muhammmmadziam1234-eng/industrial-sensor-carrier-pcb/media/four-layer-inspection.png

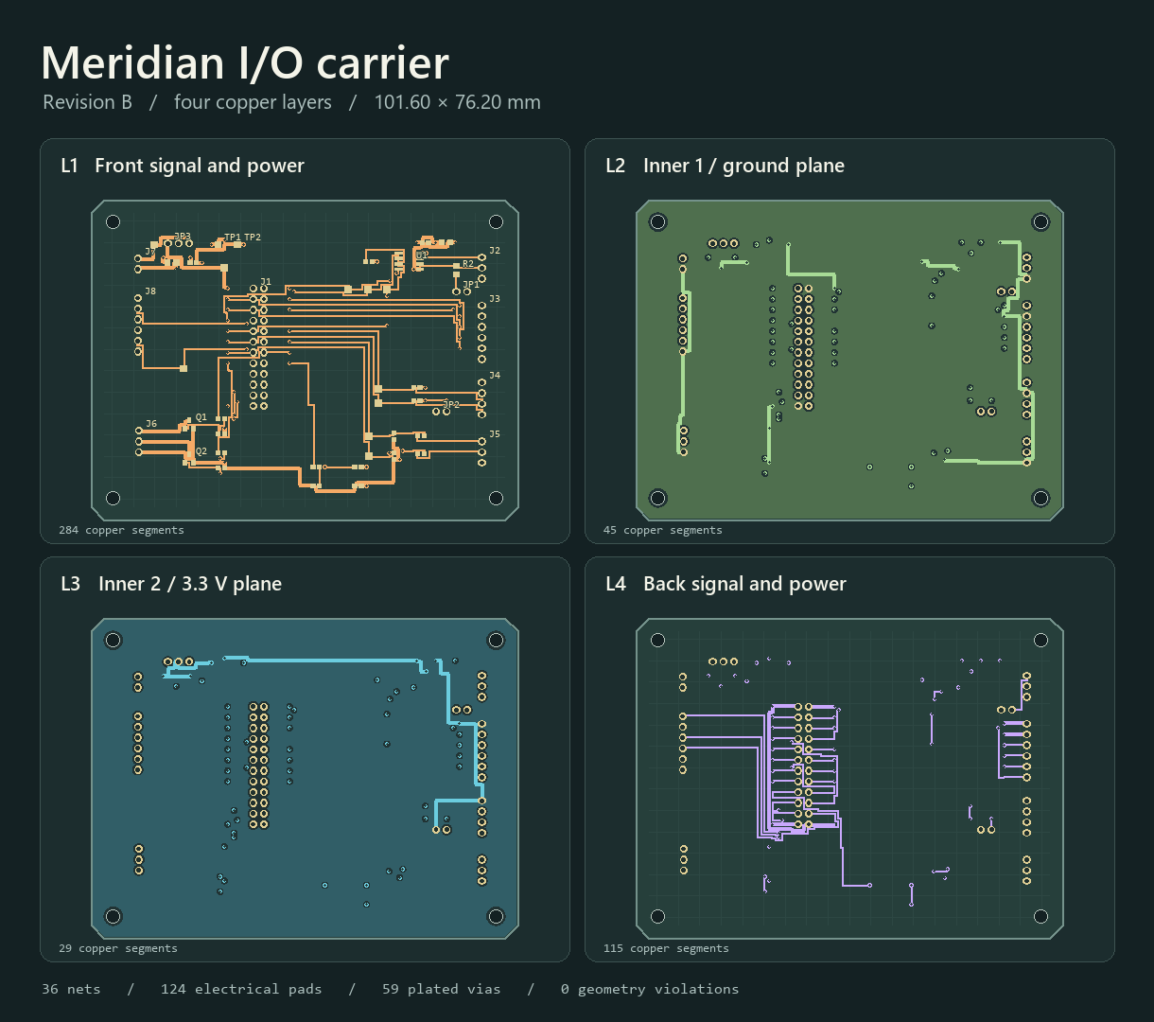
media/four-layer-inspection.png
