muhammmmadziam1234-eng/industrial-sensor-carrier-pcb/cad/pad-net-map.csv

Reference | Pad | Net | CAD x mm | CAD y mm | Drill mm
J1 | 1 | CTRL_3V3 | 38.608 | 55.118 | 1.05
J1 | 2 | GND | 41.148 | 55.118 | 1.05
J1 | 3 | SPI_SCK | 38.608 | 52.578 | 1.05
J1 | 4 | SPI_MOSI | 41.148 | 52.578 | 1.05
J1 | 5 | SPI_MISO | 38.608 | 50.038 | 1.05
J1 | 6 | SPI_CS0 | 41.148 | 50.038 | 1.05
J1 | 7 | UART_TX | 38.608 | 47.498 | 1.05
J1 | 8 | UART_RX | 41.148 | 47.498 | 1.05
J1 | 9 | RS_DIR | 38.608 | 44.958 | 1.05
J1 | 10 | I2C_SDA | 41.148 | 44.958 | 1.05
J1 | 11 | I2C_SCL | 38.608 | 42.418 | 1.05
J1 | 12 | ADC0 | 41.148 | 42.418 | 1.05
J1 | 13 | ADC1 | 38.608 | 39.878 | 1.05
J1 | 14 | OUT0 | 41.148 | 39.878 | 1.05
J1 | 15 | OUT1 | 38.608 | 37.338 | 1.05
J1 | 16 | LED0 | 41.148 | 37.338 | 1.05
J1 | 17 | LED1 | 38.608 | 34.798 | 1.05
J1 | 18 | RESET_N | 41.148 | 34.798 | 1.05
J1 | 19 | GPIO0 | 38.608 | 32.258 | 1.05
J1 | 20 | GPIO1 | 41.148 | 32.258 | 1.05
J1 | 21 | GPIO2 | 38.608 | 29.718 | 1.05
J1 | 22 | GPIO3 | 41.148 | 29.718 | 1.05
J1 | 23 | GND | 38.608 | 27.178 | 1.05
J1 | 24 | CTRL_3V3 | 41.148 | 27.178 | 1.05
J2 | 1 | RS_B | 92.964 | 62.484 | 1.05
J2 | 2 | RS_A | 92.964 | 59.944 | 1.05
J2 | 3 | GND | 92.964 | 57.404 | 1.05
J3 | 1 | 3V3 | 92.964 | 51.054 | 1.05
J3 | 2 | GND | 92.964 | 48.514 | 1.05
J3 | 3 | SPI_SCK | 92.964 | 45.974 | 1.05
J3 | 4 | SPI_MOSI | 92.964 | 43.434 | 1.05
J3 | 5 | SPI_MISO | 92.964 | 40.894 | 1.05
J3 | 6 | SPI_CS0 | 92.964 | 38.354 | 1.05
J4 | 1 | 3V3 | 92.964 | 32.766 | 1.05
J4 | 2 | GND | 92.964 | 30.226 | 1.05
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
TP6 | 1 | I2C_SDA | 68.326 | 31.242 | 0
TP7 | 1 | I2C_SCL | 68.326 | 27.940 | 0
TP8 | 1 | ADC0 | 66.040 | 20.066 | 0
TP9 | 1 | ADC1 | 66.040 | 15.240 | 0
TP10 | 1 | RESET_N | 22.098 | 36.068 | 0
TP11 | 1 | CTRL_3V3 | 31.750 | 59.944 | 0
TP12 | 1 | AUX_3V3 | 14.986 | 65.532 | 0
