muhammmmadziam1234-eng/industrial-sensor-carrier-pcb/cad/meridian-carrier-board.step

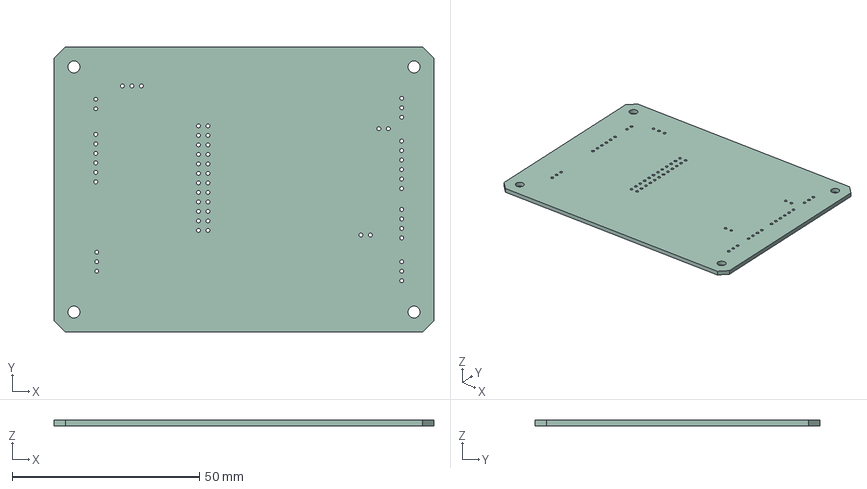
[picture p3: CAD file, 2026-11-12]
cad/meridian-carrier-board.step
101.6 x 76.2 x 1.51 mm
