muhammmmadziam1234-eng/industrial-sensor-carrier-pcb/cad/meridian-carrier.dxf

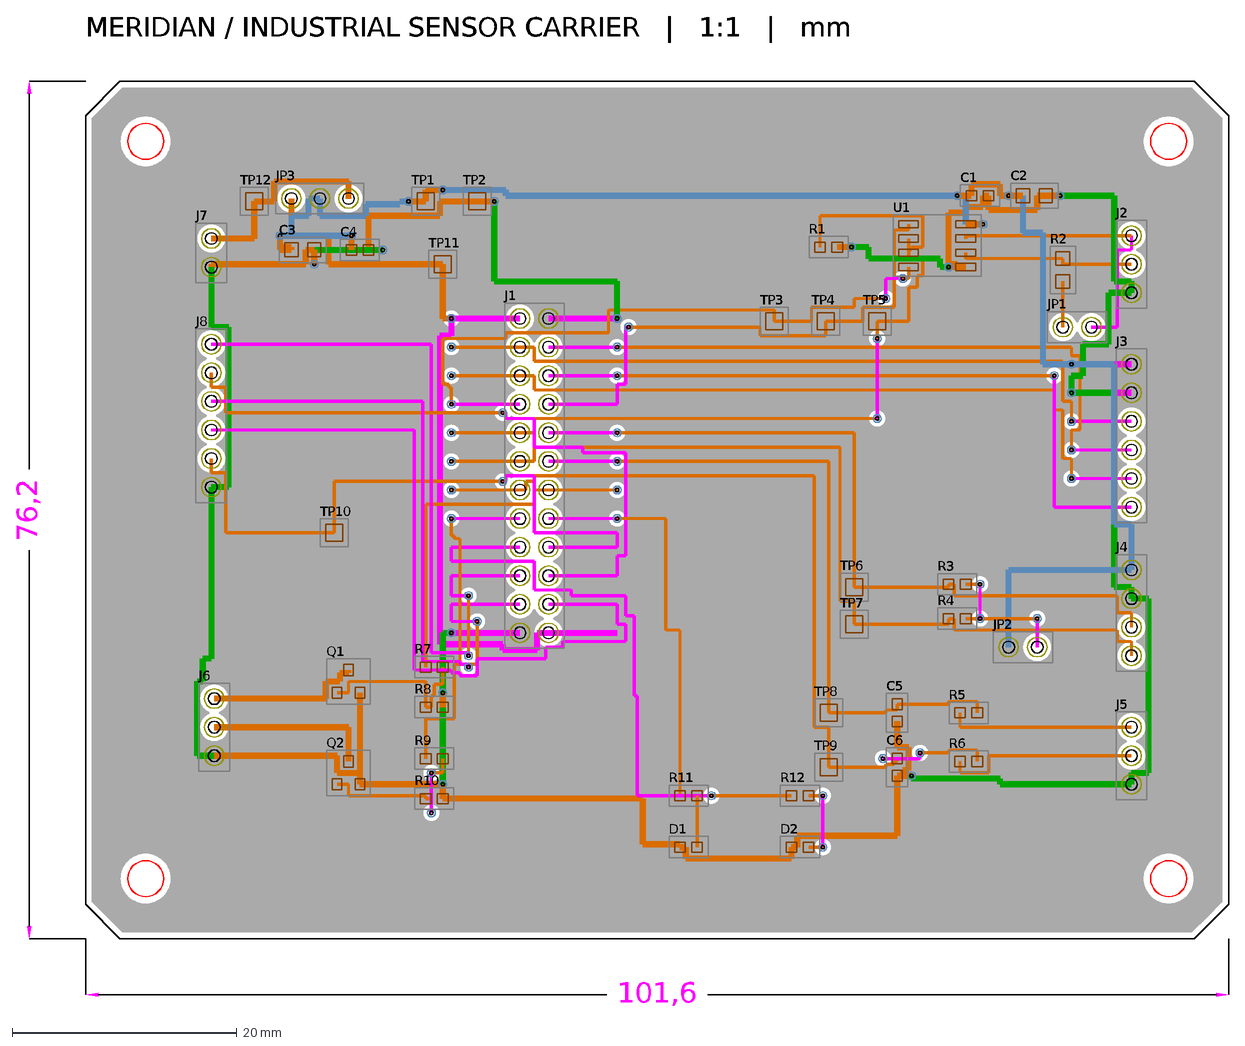
[picture p4: CAD file, 2026-11-12]
cad/meridian-carrier.dxf
J1
J2
J3
J4
J5
J6
J7
J8
JP1
JP2
JP3
U1
R1
R2
C1
C2
C3
C4
R3
R4
R5
R6
C5
C6
Q1
R7
R8
R11
D1
Q2
R9
R10
R12
D2
TP1
TP2
TP3
TP4
TP5
TP6
TP7
TP8
TP9
TP10
TP11
TP12
101,6
76,2
MERIDIAN / INDUSTRIAL SENSOR CARRIER | 1:1 | mm
