muhammmmadziam1234-eng/industrial-sensor-carrier-pcb/reports/meridian-schematic.pdf

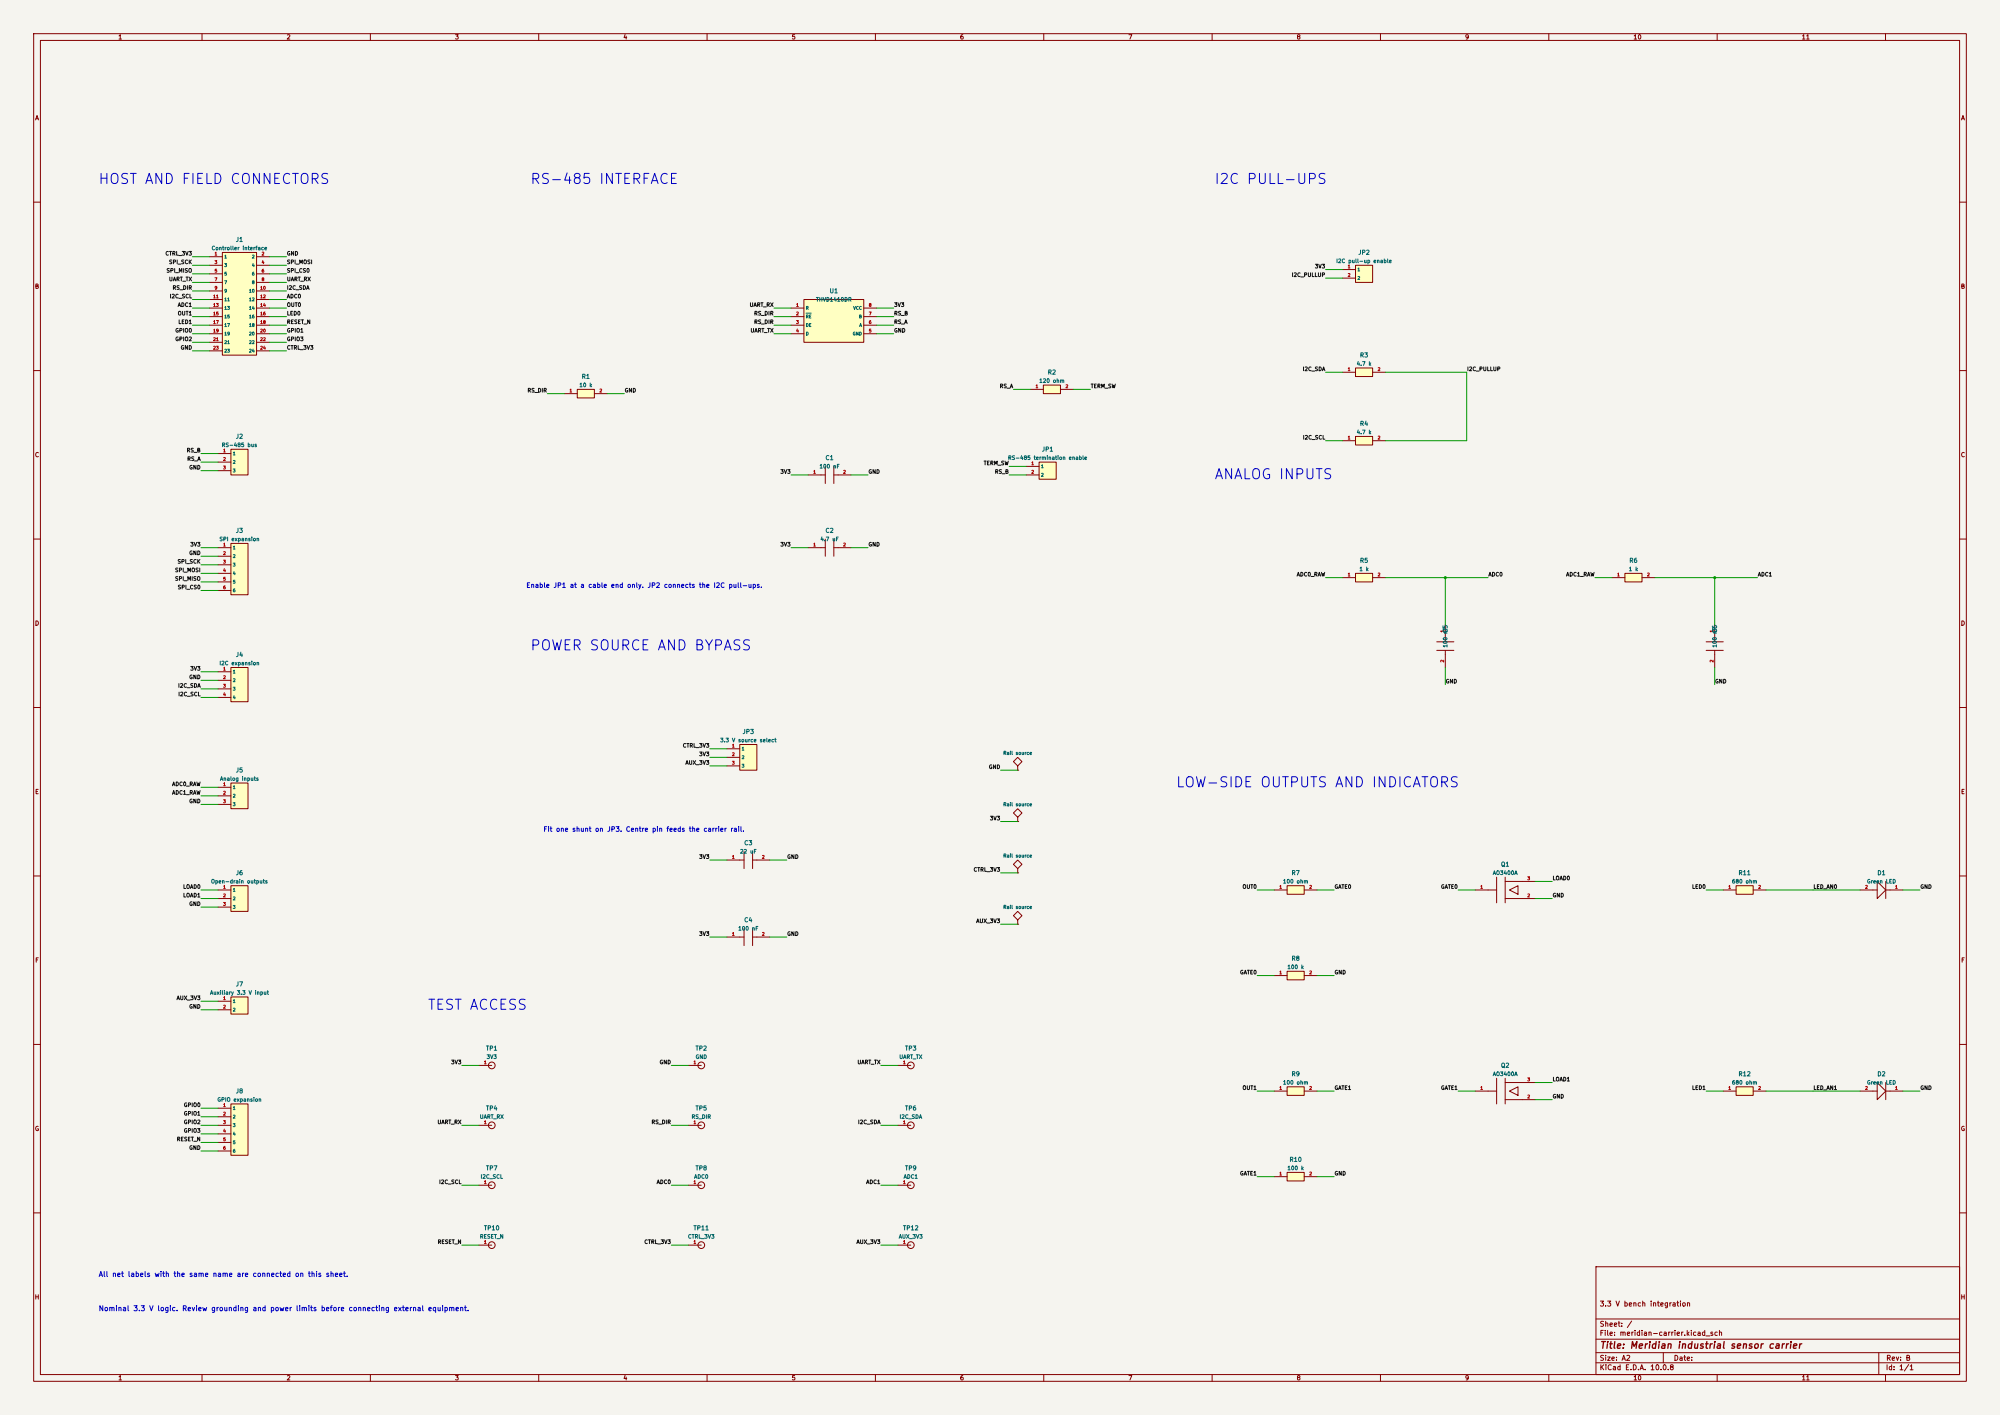
[picture p5: page 1]

POWER SOURCE AND BYPASS

Rail source

All net labels with the same name are connected on this sheet.

Nominal 3.3 V logic. Review grounding and power limits before connecting external equipment.

Sheet: /
File: meridian-carrier.kicad_sch
Title: Meridian industrial sensor carrier

Size: A2 | Rev: B
KiCad E.D.A. 10.0.8 | Id: 1/1
