muhammmmadziam1234-eng/industrial-sensor-carrier-pcb/cad/meridian-carrier.kicad_pcb

## KiCad design cad/meridian-carrier.kicad_pcb (2026-11-12)

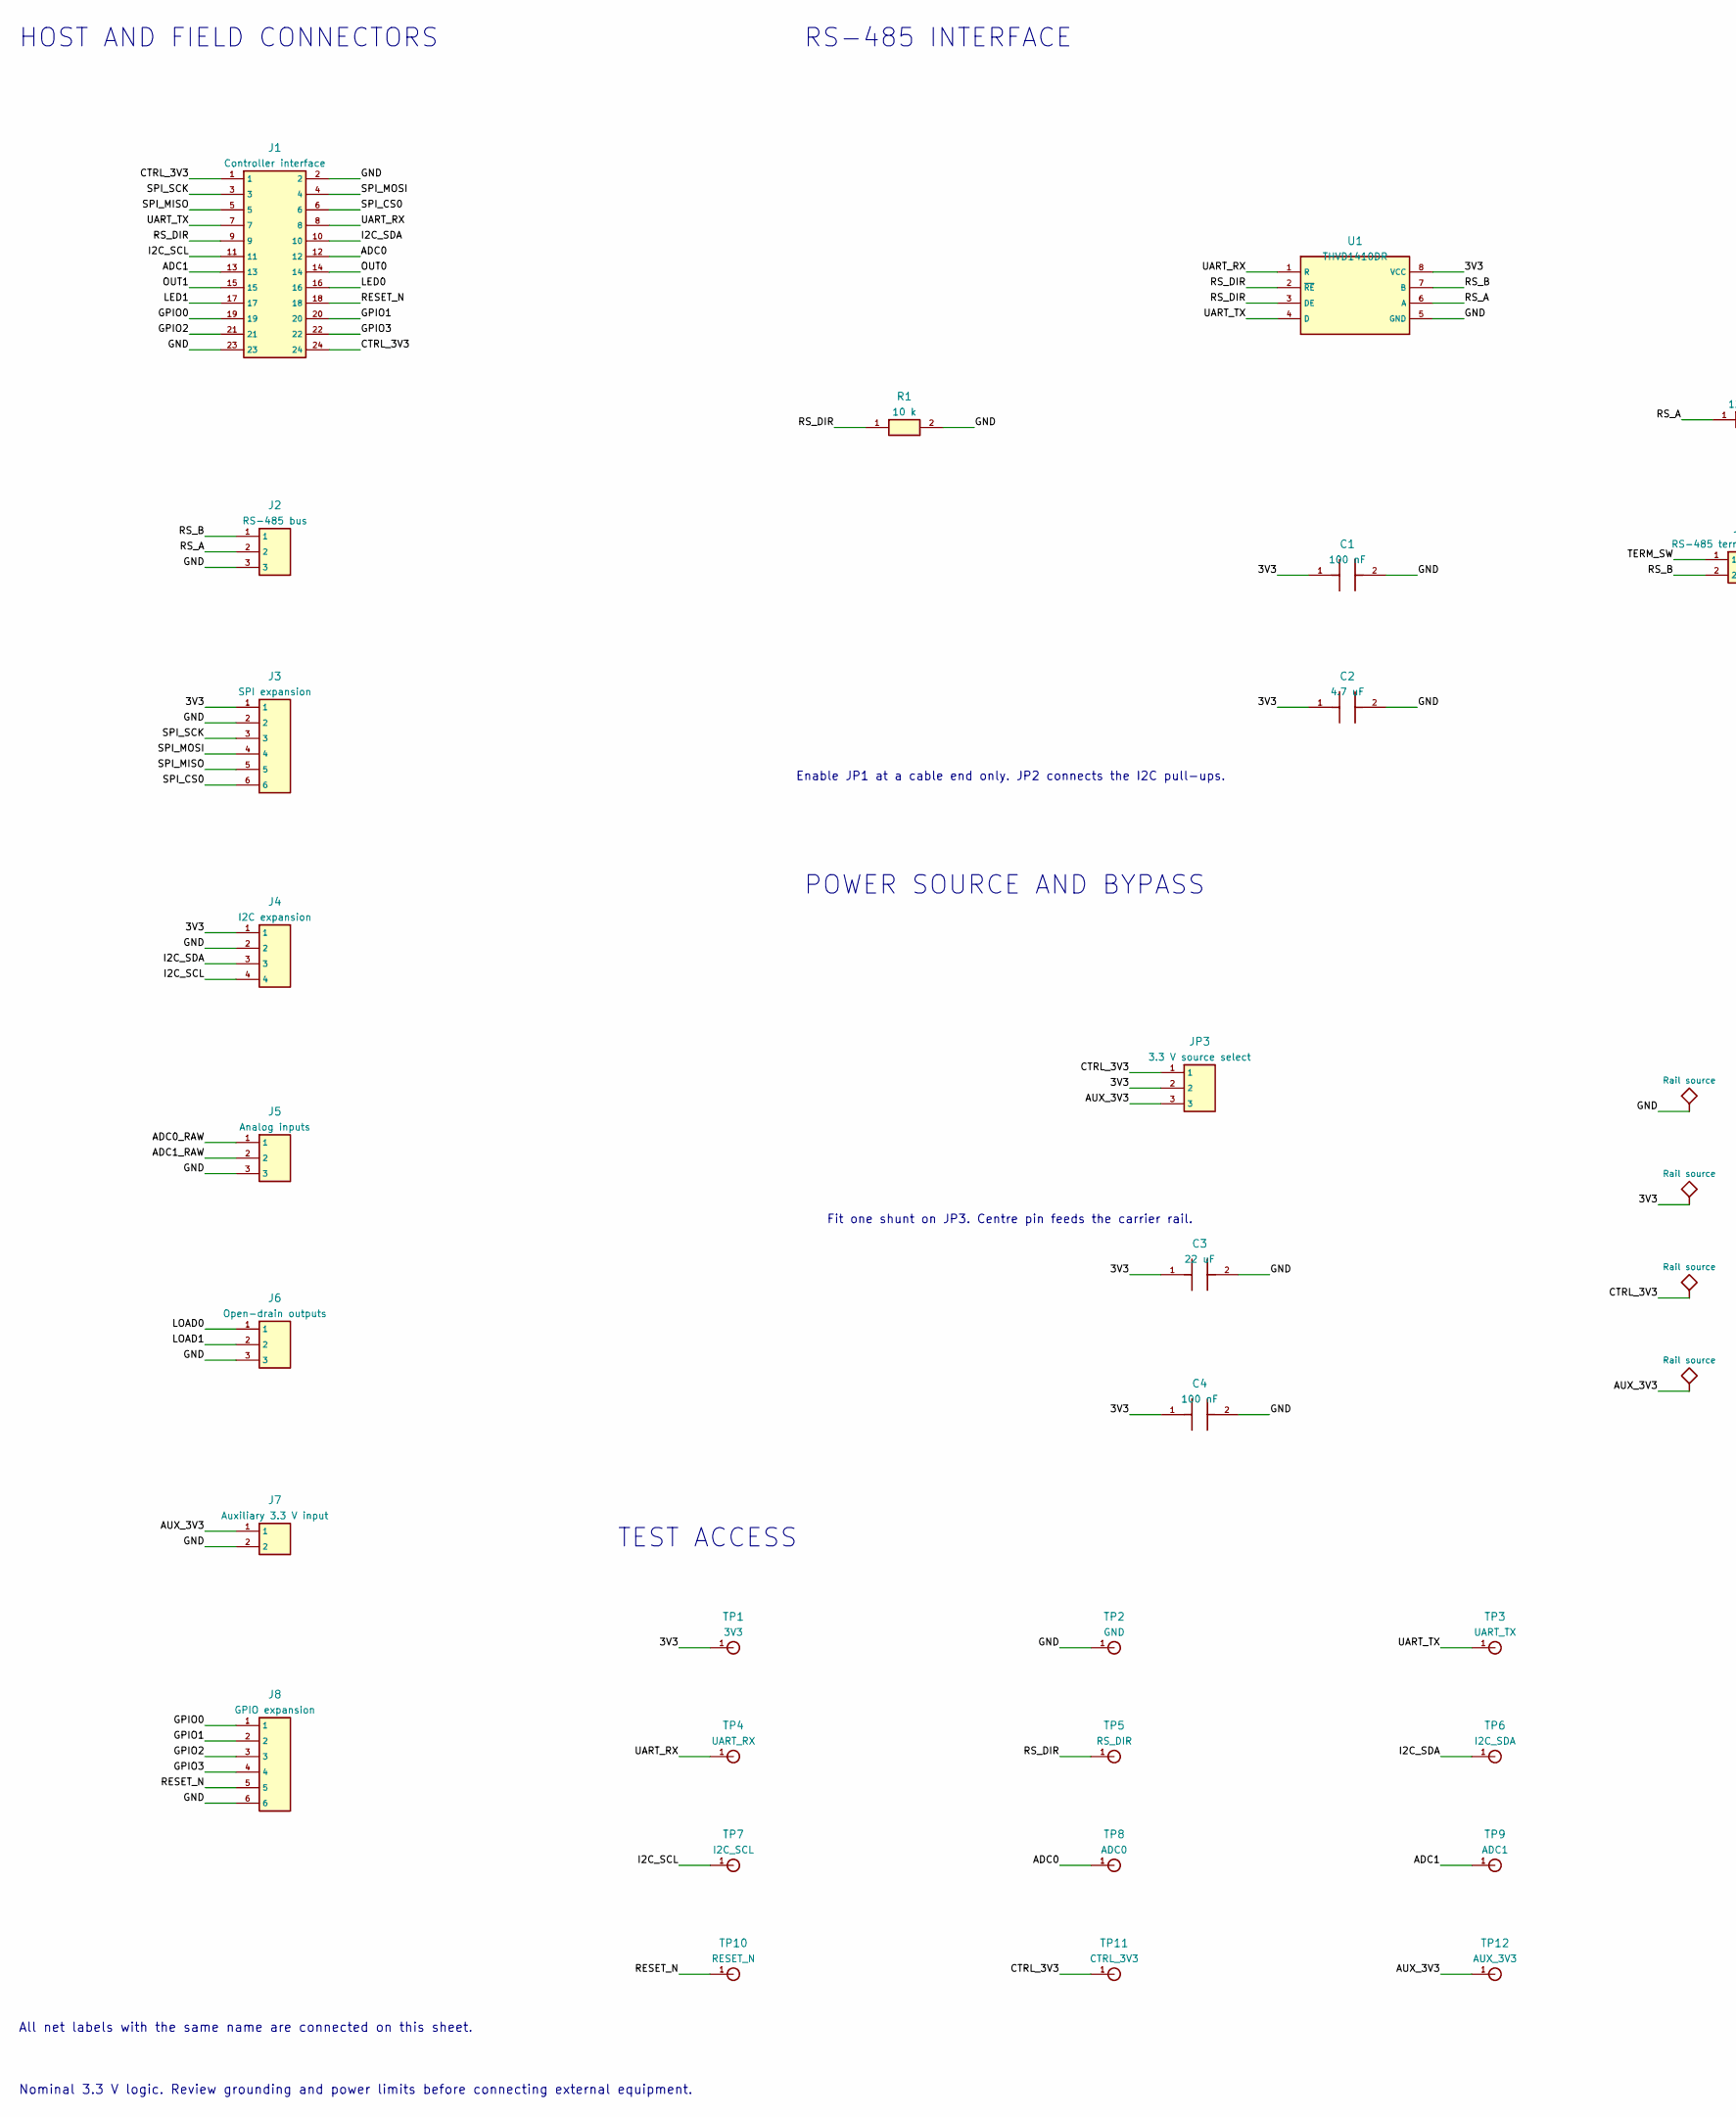
[picture p6: schematic meridian-carrier.kicad_sch, Meridian industrial sensor carrier, part in row 1, column 1]

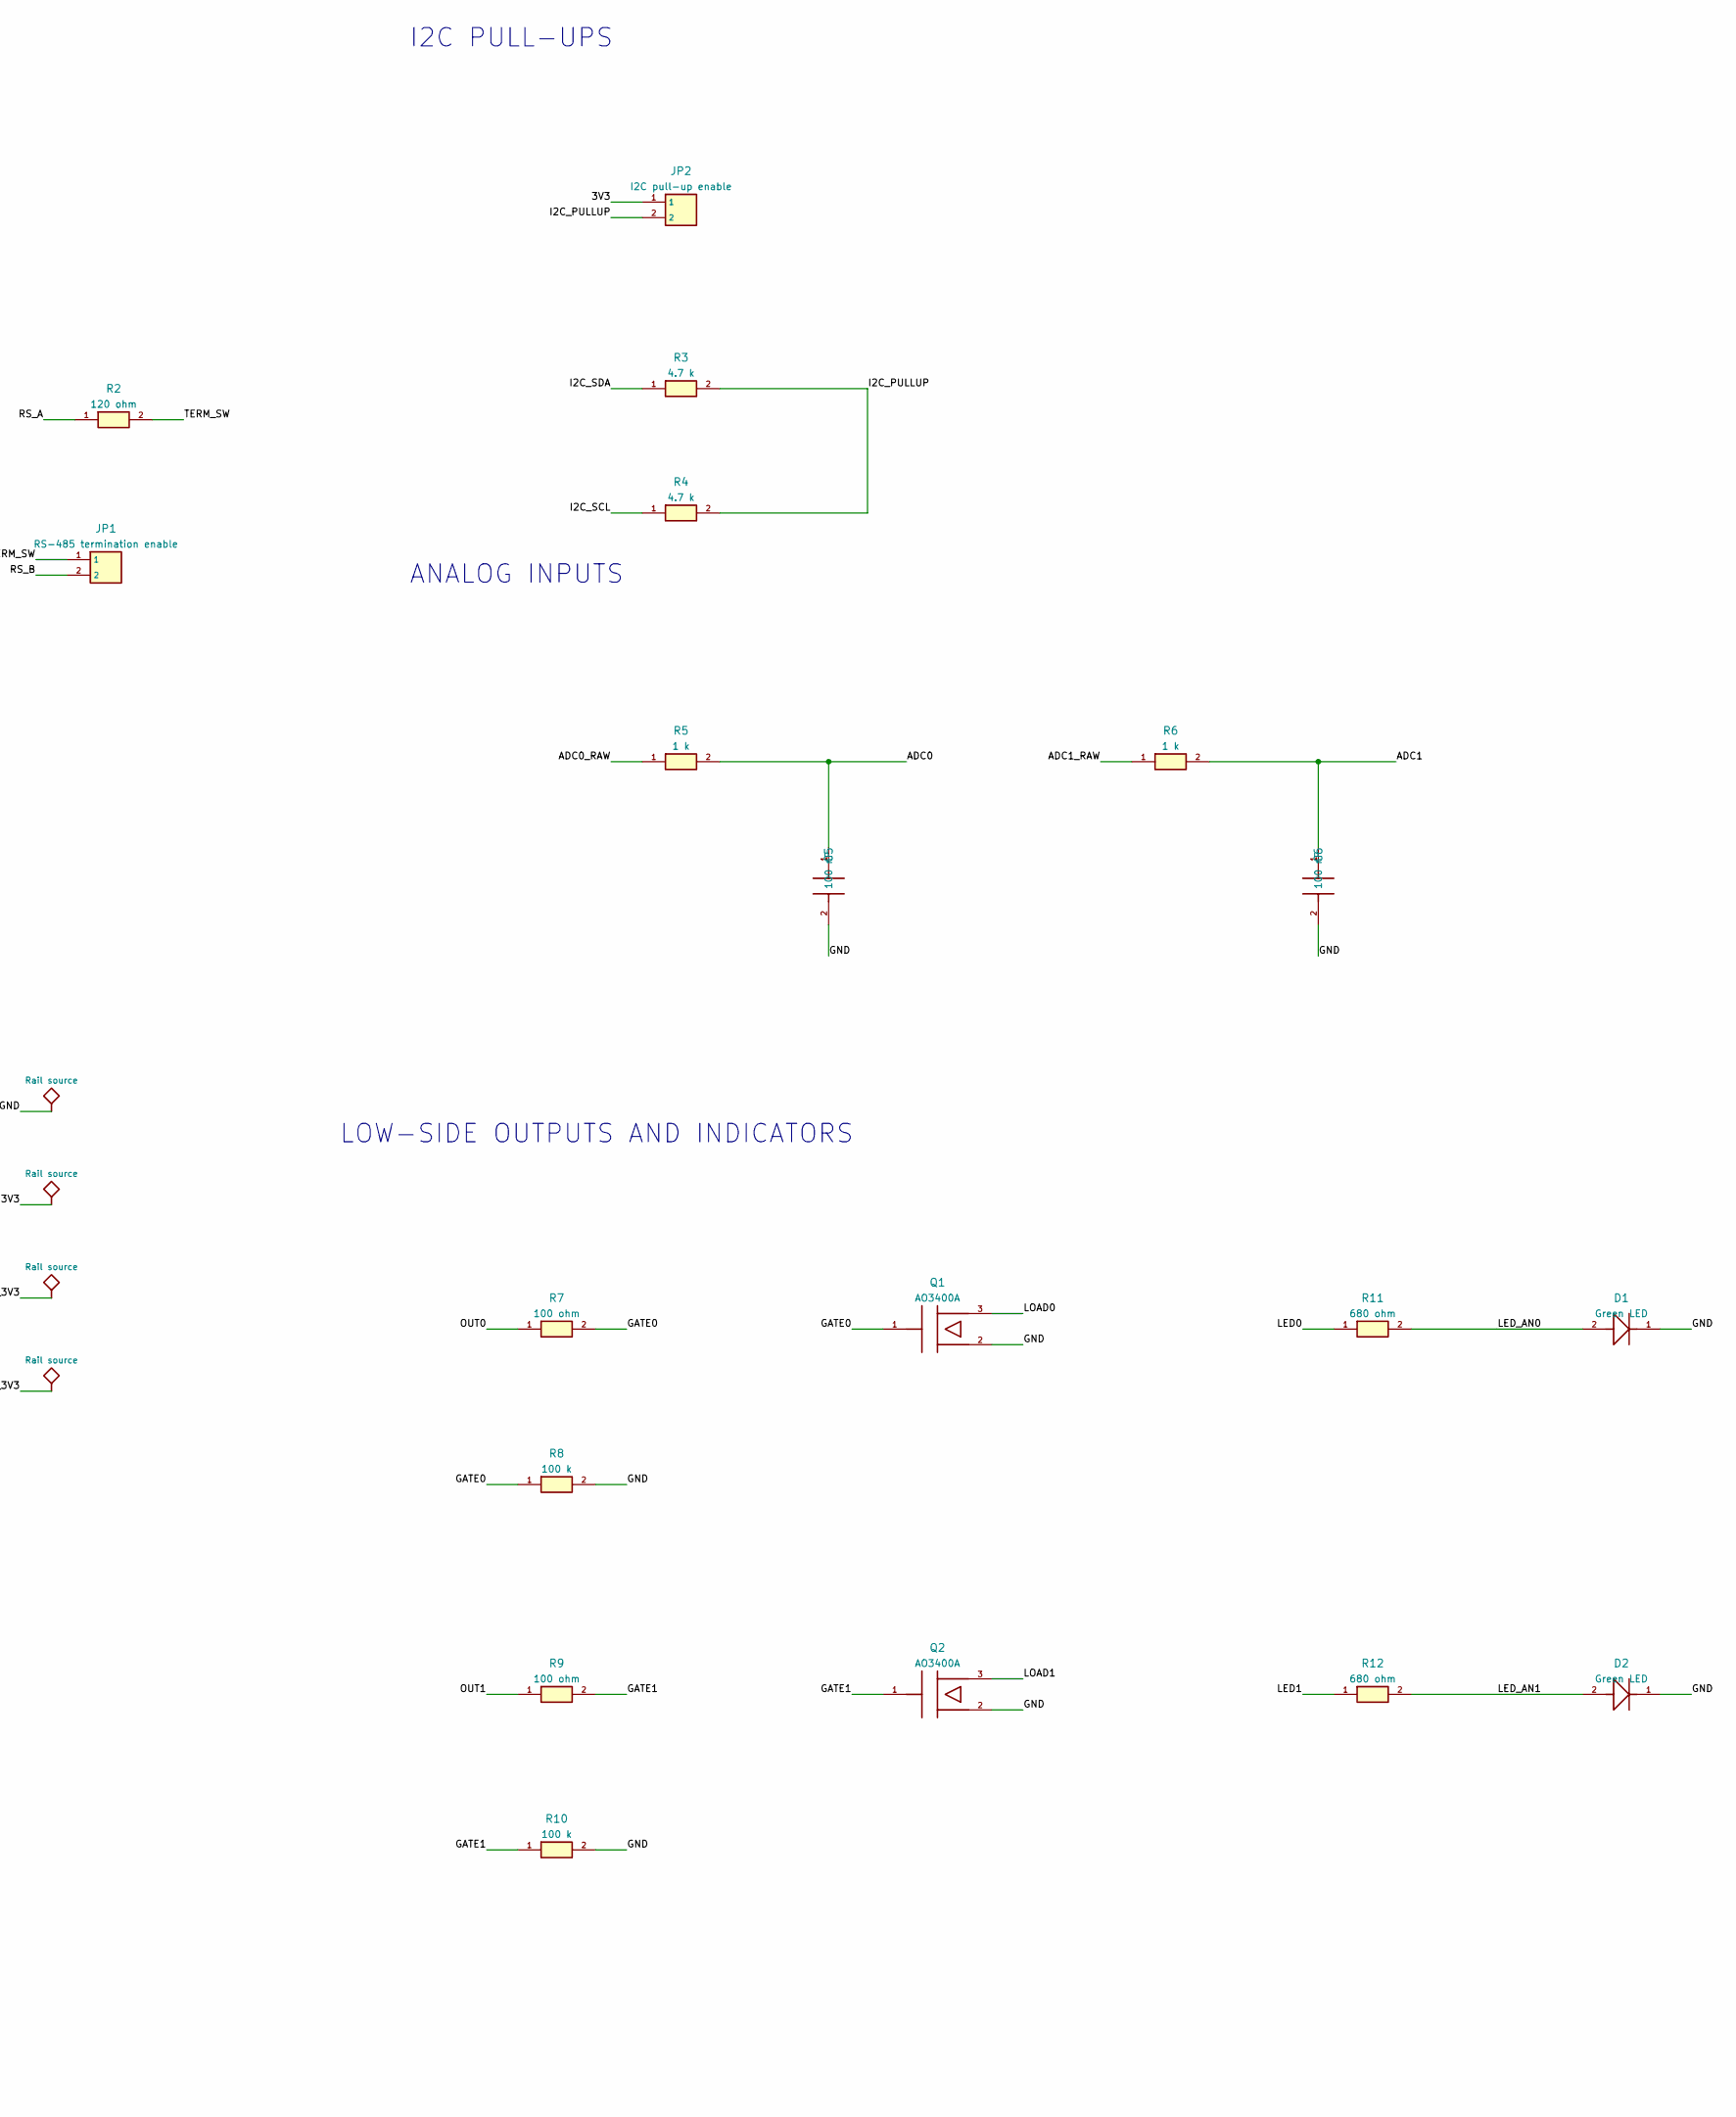
[picture p7: schematic meridian-carrier.kicad_sch, Meridian industrial sensor carrier, part in row 1, column 2]

Parts:
C1, C4: 100 nF; Chip_0603_H
C2: 4.7 uF; Chip_0805_H
C3: 22 uF; Chip_0805_H
C5, C6: 100 nF; Chip_0603_V
D1, D2: Green LED; Chip_0603_H
J1: Controller interface; Header_2x12_P2p54mm
J2: RS-485 bus; Header_1x03_V_P2p54mm
J3: SPI expansion; Header_1x06_V_P2p54mm
J4: I2C expansion; Header_1x04_V_P2p54mm
J5: Analog inputs; Header_1x03_V_P2p54mm
J6: Open-drain outputs; Header_1x03_V_P2p54mm
J7: Auxiliary 3.3 V input; Header_1x02_V_P2p54mm
J8: GPIO expansion; Header_1x06_V_P2p54mm
JP1: RS-485 termination enable; Header_1x02_H_P2p54mm
JP2: I2C pull-up enable; Header_1x02_H_P2p54mm
JP3: 3.3 V source select; Header_1x03_H_P2p54mm
Q1, Q2: AO3400A; SOT_23
R1: 10 k; Chip_0603_H
R2: 120 ohm; Chip_0805_V
R3, R4: 4.7 k; Chip_0603_H
R5, R6: 1 k; Chip_0603_H
R7, R9: 100 ohm; Chip_0603_H
R8, R10: 100 k; Chip_0603_H
R11, R12: 680 ohm; Chip_0603_H
TP1: 3V3; TestLand_1p5mm
TP2: GND; TestLand_1p5mm
TP3: UART_TX; TestLand_1p5mm
TP4: UART_RX; TestLand_1p5mm
TP5: RS_DIR; TestLand_1p5mm
TP6: I2C_SDA; TestLand_1p5mm
TP7: I2C_SCL; TestLand_1p5mm
TP8: ADC0; TestLand_1p5mm
TP9: ADC1; TestLand_1p5mm
TP10: RESET_N; TestLand_1p5mm
TP11: CTRL_3V3; TestLand_1p5mm
TP12: AUX_3V3; TestLand_1p5mm
U1: THVD1410DR; SOIC_8_3p9x4p9mm

Connections:
/3V3: C1.1, C2.1, C3.1, C4.1, J3.1, J4.1, JP2.1, JP3.2, TP1.1, U1.8 (VCC)
/ADC0: C5.1, J1.12, R5.2, TP8.1
/ADC0_RAW: J5.1, R5.1
/ADC1: C6.1, J1.13, R6.2, TP9.1
/ADC1_RAW: J5.2, R6.1
/AUX_3V3: J7.1, JP3.3, TP12.1
/CTRL_3V3: J1.1, J1.24, JP3.1, TP11.1
/GATE0: Q1.1 (G), R7.2, R8.1
/GATE1: Q2.1 (G), R9.2, R10.1
/GND: C1.2, C2.2, C3.2, C4.2, C5.2, C6.2, D1.1, D2.1, J1.2, J1.23, J2.3, J3.2, J4.2, J5.3, J6.3, J7.2, J8.6, Q1.2 (S), Q2.2 (S), R1.2, R8.2, R10.2, TP2.1, U1.5 (GND)
/GPIO0: J1.19, J8.1
/GPIO1: J1.20, J8.2
/GPIO2: J1.21, J8.3
/GPIO3: J1.22, J8.4
/I2C_PULLUP: JP2.2, R3.2, R4.2
/I2C_SCL: J1.11, J4.4, R4.1, TP7.1
/I2C_SDA: J1.10, J4.3, R3.1, TP6.1
/LED0: J1.16, R11.1
/LED1: J1.17, R12.1
/LED_AN0: D1.2, R11.2
/LED_AN1: D2.2, R12.2
/LOAD0: J6.1, Q1.3 (D)
/LOAD1: J6.2, Q2.3 (D)
/OUT0: J1.14, R7.1
/OUT1: J1.15, R9.1
/RESET_N: J1.18, J8.5, TP10.1
/RS_A: J2.2, R2.1, U1.6 (A)
/RS_B: J2.1, JP1.2, U1.7 (B)
/RS_DIR: J1.9, R1.1, TP5.1, U1.2 (~RE), U1.3 (DE)
/SPI_CS0: J1.6, J3.6
/SPI_MISO: J1.5, J3.5
/SPI_MOSI: J1.4, J3.4
/SPI_SCK: J1.3, J3.3
/TERM_SW: JP1.1, R2.2
/UART_RX: J1.8, TP4.1, U1.1 (R)
/UART_TX: J1.7, TP3.1, U1.4 (D)

Notes on the sheet:
HOST AND FIELD CONNECTORS
RS-485 INTERFACE
POWER SOURCE AND BYPASS
TEST ACCESS
I2C PULL-UPS
ANALOG INPUTS
LOW-SIDE OUTPUTS AND INDICATORS
Fit one shunt on JP3. Centre pin feeds the carrier rail.
Enable JP1 at a cable end only. JP2 connects the I2C pull-ups.
All net labels with the same name are connected on this sheet.
Nominal 3.3 V logic. Review grounding and power limits before connecting external equipment.

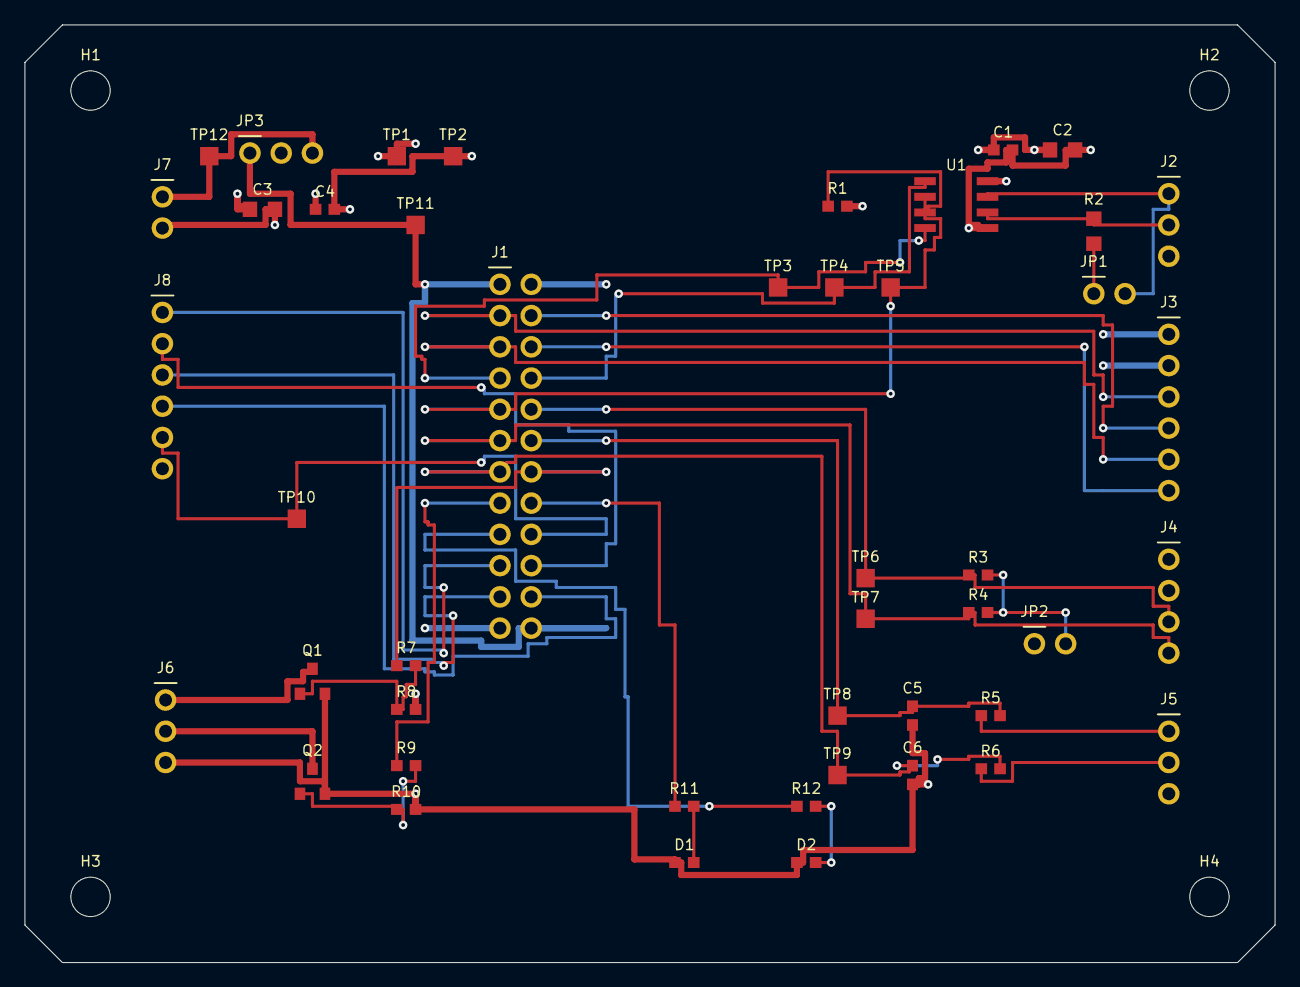
[picture p8: board meridian-carrier.kicad_pcb from above]

Board: 4 copper layers, 101.6 x 76.2 mm, 50 parts (0 on the bottom side), 36 nets.

Other parts of the board:
H1, H2, H3, H4: Mount_M3
