muhammmmadziam1234-eng/industrial-sensor-carrier-pcb/(commit log)

2026-11-12 Add portfolio project
    [bill-of-materials.csv, meridian-carrier.dxf, meridian-carrier.kicad_pcb, pad-net-map.csv]
2026-11-12 Prepare Revision B PCB engineering handoff
    [bill-of-materials.csv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]
2026-11-12 Add verified mechanical exchange and first-article acceptance
    [meridian-carrier-board.step]
